weitec123/w48-audio-guestbook/(commit log)

2026-10-17 Initial commit: W48 Audio Guestbook (ESP32-S3, MicroSD 16-bit PCM, WiFi noise-free)
2026-10-17 Add parts list and wiring diagram to README
2026-10-17 Add visual wiring diagram image to README
2026-10-17 Update wiring diagram: add 4-wire W48 handset with desoldered mic capsule
2026-10-17 Make README universally applicable for any vintage telephone / DIY enclosure
